Lorangs/TFE4152_prosjektoppgave/README.txt

TFE4152 Design av Integrete kretser, prosjektoppgave H24

Dato:           14. oktober 2024
Skrevet av:     Lorang Strand & Sebastian W. Kalland.

Icarus Verilog er brukt som komilator for Verilog. 
kilde: https://steveicarus.github.io/iverilog/

Youtube video for introduksjon til Verilog:
https://www.youtube.com/watch?v=nblGw37Fv8A&t=5138s

Terminal kommandoer for simulering av Verilog testbenker:

iverilog FILEPATH
vvp OUTPUTFILE
gtkwave VCDFILE
