Lorangs/TFE4152_prosjektoppgave/LaTeX_2/main.tex

\documentclass{article}
\usepackage{graphicx} % Required for inserting images
\usepackage{svg} % Makes it possible to include svg-images
\usepackage{cite}
\usepackage[a4paper, total={6in, 8in}]{geometry}
\usepackage{float}
\usepackage{siunitx}
\usepackage{minted}
\usepackage{titlesec}

% --- Mathematics ---
\usepackage{bm}         % Bold text in math mode
\usepackage{amsmath}    % Math formulas and improved typographical quality of their output
\usepackage{amssymb}    % Extended symbol collection
\usepackage{amsthm}     % Helps define theorem-like structures
\usepackage{textcomp}   % Used in the package "gensymb" (below), which will give warnings if "textcomp" is not imported in advance
\usepackage{gensymb}    % Adds extra generic symbols for math and text mode, e.g. \degree
\usepackage{subfigure}
\usepackage{subcaption}

% --- Main matter ---
% This is the main part of the paper.
\newcommand{\mainmatter}{
    \newpage
    \pagenumbering{arabic}  % Setting page numbering to normal integers
}

\usepackage[colorlinks=true,allcolors=black]{hyperref}
\usepackage[british]{babel}     % Defining UK English as language. This will among other things ensure that dates are displayed as 24/03/1997 rather than 03/24/1997 in the bibliography.
\addto\extrasbritish{   % Change naming of different functions, e.g. figure references.
    \renewcommand*\contentsname{Table of Contents}  % Rename table of contents
    \renewcommand{\listfigurename}{List of Figures} % Rename list of figures
    \renewcommand{\listtablename}{List of Tables}   % Rename list of tables
    \def\equationautorefname{Equation}              % Autoref-name for equations
    \def\figureautorefname{Figure}                  % Autoref-name for figures
    \def\tableautorefname{Table}                    % Autoref-name for tables
    \def\sectionautorefname{Section}                % Autoref-name for sections
    \def\subsectionautorefname{Subsection} % Autoref-name for subsections
    \def\subsubsectionautorefname{Subsection} % Autoref-name for subsubsections
}

\begin{document}

\begin{titlepage}
\vbox{ }
\vbox{ }
\begin{center}
% Upper part of the page
\includesvg[width=\textwidth]{Figures/logo.svg}\\[1cm]
\textsc{\LARGE TFE4152 Design of Integrated Circuits}\\[1cm]
\textsc{\Large Term project fall 2024}\\[0.5cm]
\vbox{ }

% Title
{ \huge \bfseries 8x8-bit Memory Module}\\[0.4cm] 

% Author
\large
\emph{Authors:}\\
L. Strand \& S.W. Kalland \\
Group 3
\vfill

\end{center}
\end{titlepage}

\input{Text/0_Abstract} \newpage
\tableofcontents \newpage
\input{Text/1_Introduction} 
\input{Text/2_Theory} 
\input{Text/3_Method} \newpage
\input{Text/4_Results} 
\input{Text/5_Discussion} 
\input{Text/6_Conclusion} \newpage

\addcontentsline{toc}{section}{References}
\bibliographystyle{unsrt}
\bibliography{bibliography}

\include{Text/7_appendix.tex}
\end{document}
