Lorangs/TFE4152_prosjektoppgave/aimSpice/plots/plotsFF/func27c.png

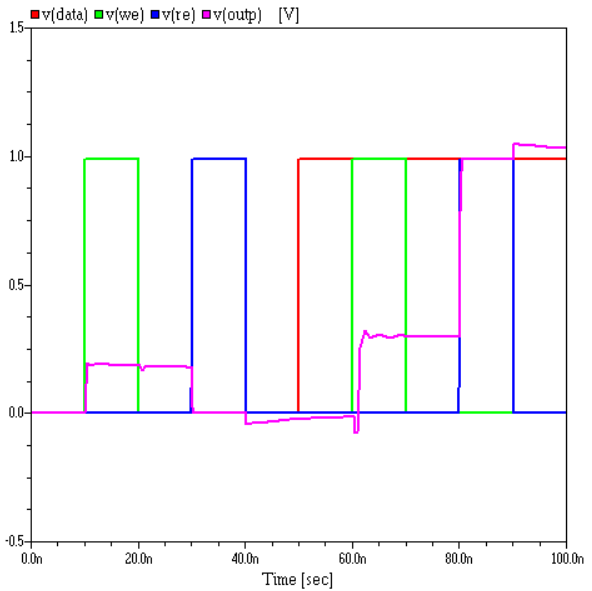
aimSpice/plots/plotsFF/func27c.png
