Lorangs/TFE4152_prosjektoppgave/aimSpice/plots/plotsFF/func50c.png

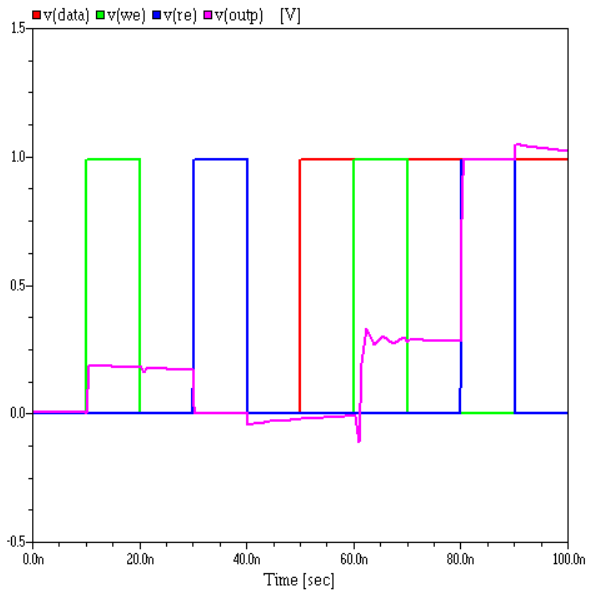
aimSpice/plots/plotsFF/func50c.png
