Lorangs/TFE4152_prosjektoppgave/aimSpice/plots/plotsFF/func-20c.png

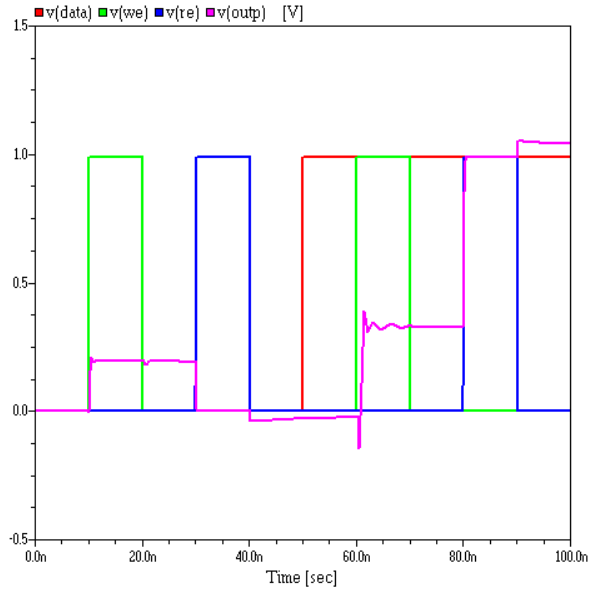
aimSpice/plots/plotsFF/func-20c.png
