Lorangs/TFE4152_prosjektoppgave/aimSpice/plots/plotsFF/leak.png

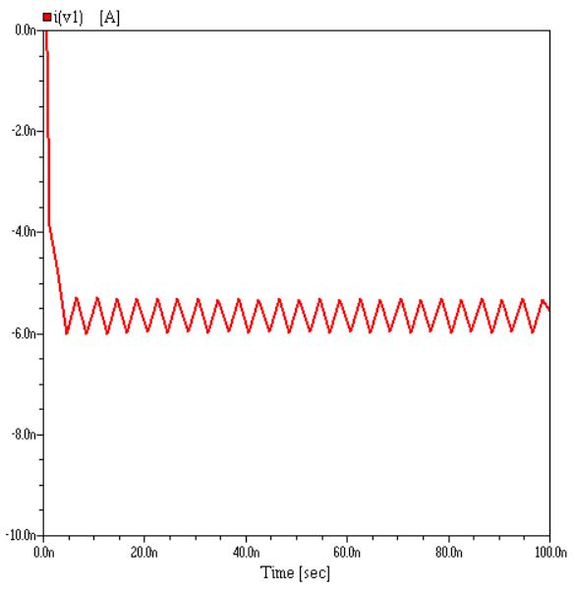
aimSpice/plots/plotsFF/leak.png
