Lorangs/TFE4152_prosjektoppgave/aimSpice/plots/plotsFF/read.png

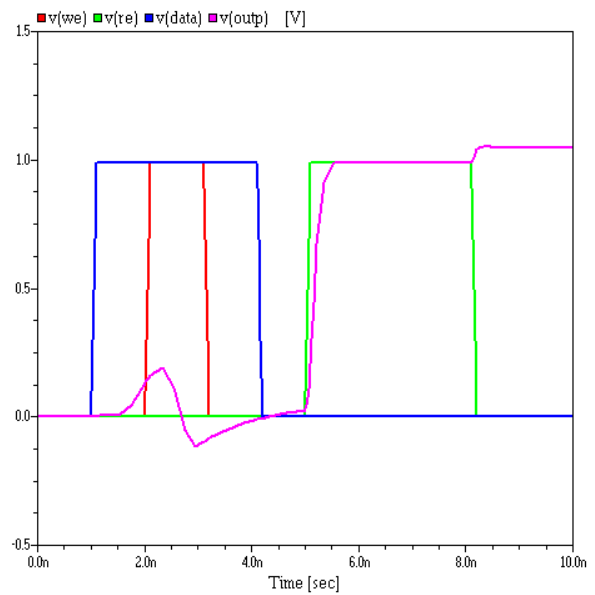
aimSpice/plots/plotsFF/read.png
