Lorangs/TFE4152_prosjektoppgave/aimSpice/plots/plotsFF/write.png

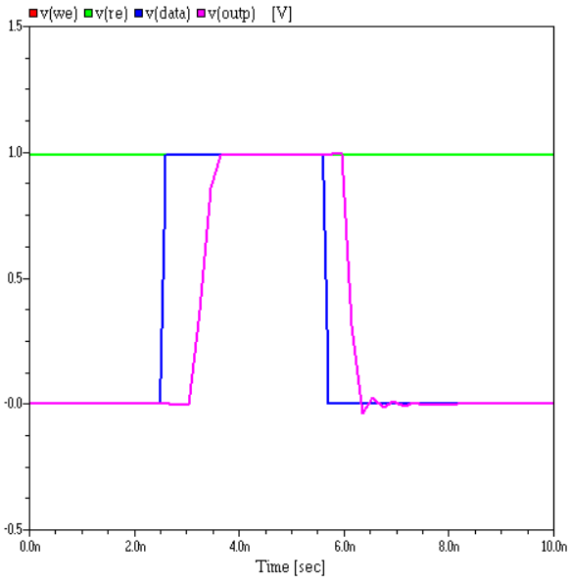
aimSpice/plots/plotsFF/write.png
