Lorangs/TFE4152_prosjektoppgave/aimSpice/plots/plotsFS/func50c.png

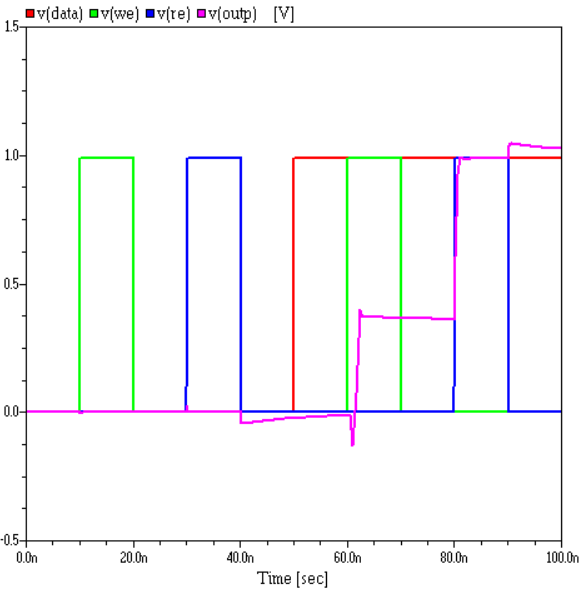
aimSpice/plots/plotsFS/func50c.png
