Lorangs/TFE4152_prosjektoppgave/aimSpice/plots/plotsSF/func27c.png

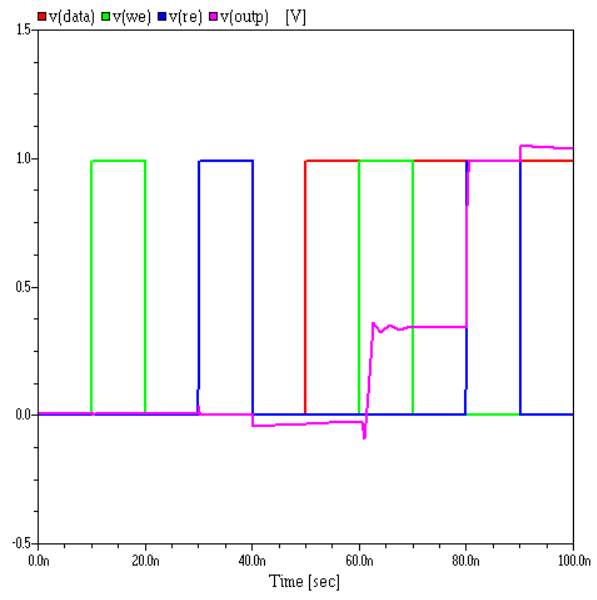
aimSpice/plots/plotsSF/func27c.png
