Lorangs/TFE4152_prosjektoppgave/aimSpice/plots/plotsSS/func50c.png

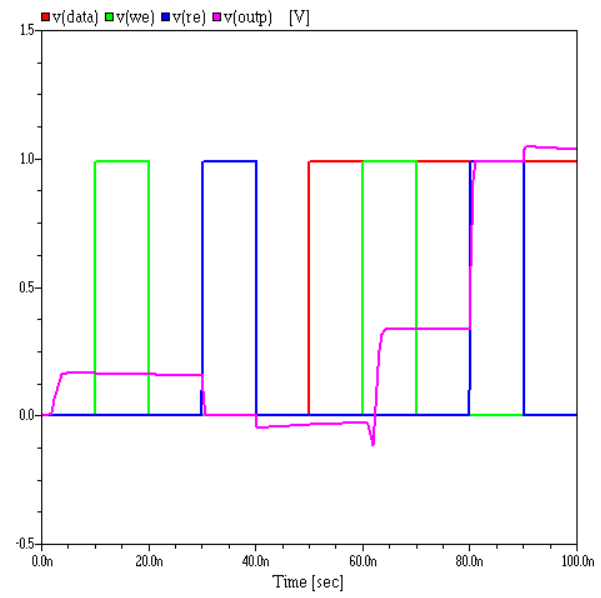
aimSpice/plots/plotsSS/func50c.png
