Lorangs/TFE4152_prosjektoppgave/aimSpice/plots/plotsSS/func-20c.png

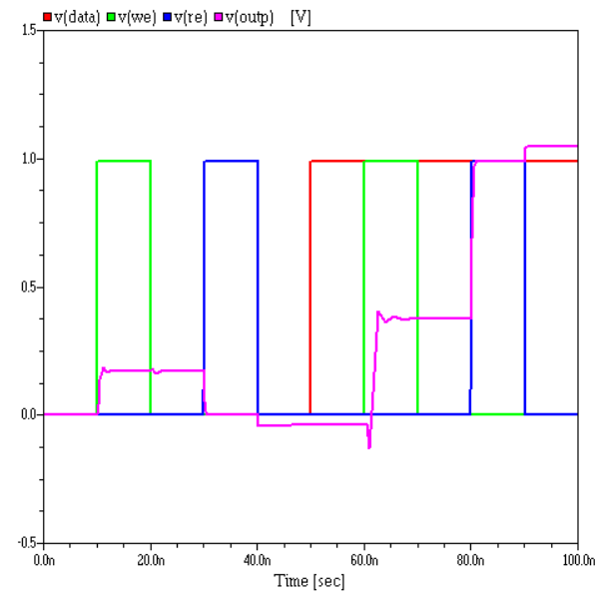
aimSpice/plots/plotsSS/func-20c.png
