Lorangs/TFE4152_prosjektoppgave/aimSpice/plots/plotsSS/read.png

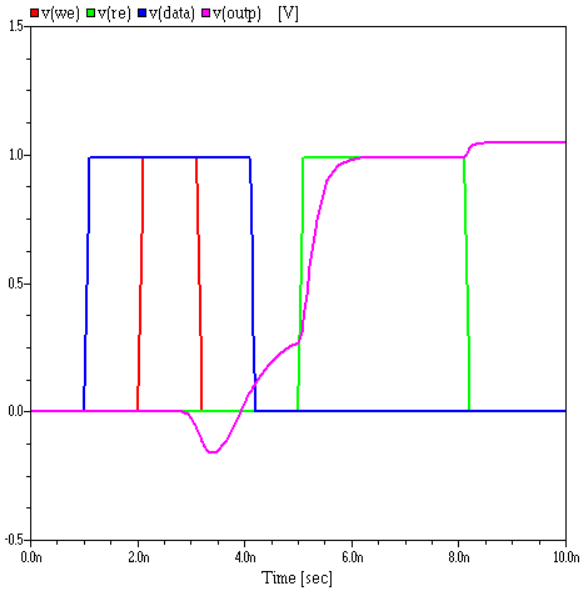
aimSpice/plots/plotsSS/read.png
