Lorangs/TFE4152_prosjektoppgave/aimSpice/plots/plotsTT/read.png

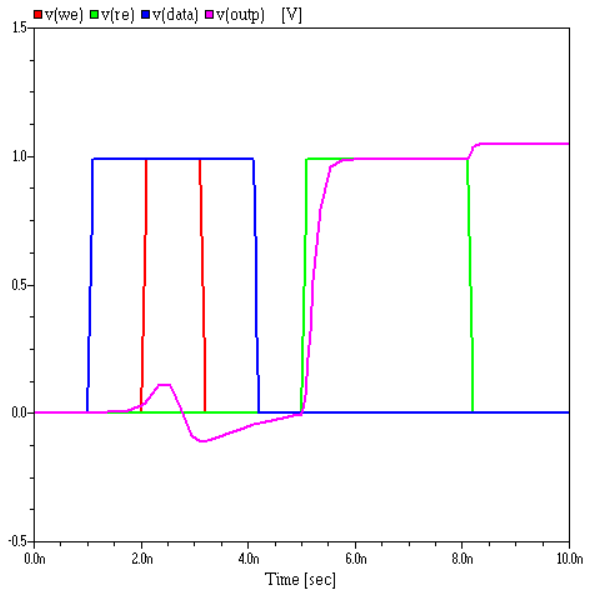
aimSpice/plots/plotsTT/read.png
