Lorangs/TFE4152_prosjektoppgave/aimSpice/plots/plotsTT/write.png

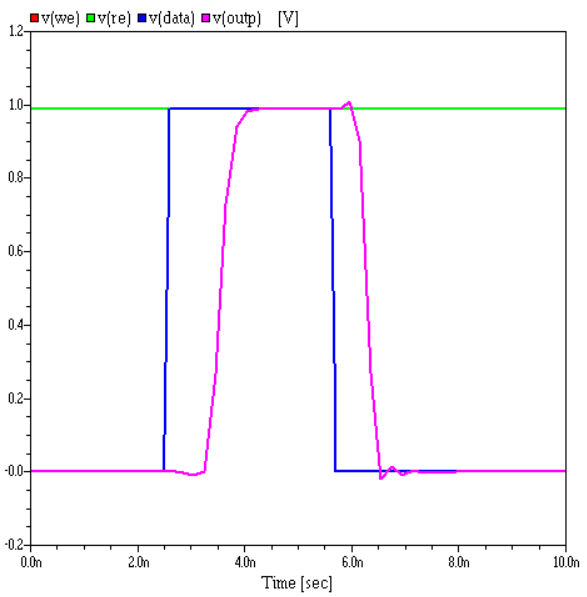
aimSpice/plots/plotsTT/write.png
