Lorangs/TFE4152_prosjektoppgave/LaTeX_2/Figures/flipflop.png

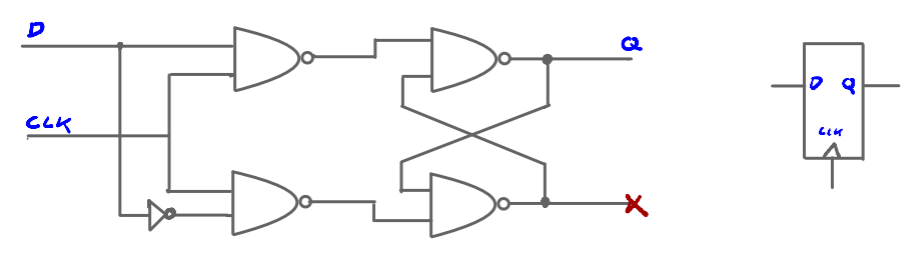
LaTeX_2/Figures/flipflop.png
