Lorangs/TFE4152_prosjektoppgave/LaTeX_2/Text/4_Results.tex

\section{Simulations and Results}   \label{sec:04:results}
All analog simulations are performed in the language of \textit{AIMSpice} in the \textit{AIM-Spice} computer program. All digital simulations are performed in the language \textit{Verilog}, with the editor \textit{VSCode}, compiler \textit{Icarus Verilog} and waveform plotter \textit{gtkwave}. All codes used to simulate can be found in the appendix, \autoref{sec:07:appendix}.

\subsection{Analog bitcell}
The analog behavior of the bitcell is simulated to show its functionality at different temperatures, and its read-time, write-time and leakage current at the \textit{SS}, \textit{TT} and \textit{FF} transistors operating corners.

\subsubsection{Leakage current}
The leakage currents at different configurations are shown in \autoref{fig:04:leakage}. The current is negative, so keep in mind that it is the absolute value of the current which is of interest. It would ideally be as close to zero as possible to keep power consumption down.

\begin{figure}[H]
    \centering
    
    
    
    \caption{Leakage currents at \textit{SS}, \textit{TT} and \textit{FF} (from left to right).}
    \label{fig:04:leakage}
\end{figure}

\subsubsection{Read time}
The read times can be seen in \autoref{fig:04:read}. They are all shorter than \SI{3}{ns}, which is the length of the \textit{RE} pulse, as was required in the project description.

\begin{figure}[H]
    \centering
    
    
    
    \caption{The read times to the bitcell at \textit{SS}, \textit{TT} and \textit{FF} (from left to right) can be read as the time it takes v(outp) to reach v(re).}
    \label{fig:04:read}
\end{figure}

\subsubsection{Write time}
The write times can be seen in \autoref{fig:04:read}. They are also all shorter than \SI{3}{ns}, which is the length of the \textit{inp} pulse, as was required in the project description.

\begin{figure}[H]
    \centering
    
    
    
    \caption{The write times to the bitcell at \textit{SS}, \textit{TT} and \textit{FF} (from left to right) can be read as the time it takes \textit{v(outp)} to reach \textit{v(data)}.}
    \label{fig:04:write}
\end{figure}

\subsubsection{Temperature Functionality}
The circuit is tested at three different temperatures (\SI{-20}{C}, \SI{27}{C}, \SI{50}{C}) for five different circuit configurations (\textit{FF, FS, SF, SS, TT}). The test is comprised of writing, storing and reading a logical low, and then a logical high. The functionality tests perform as can be seen in \autoref{fig:04:func}. 

\begin{figure}[H]
    \centering
    FF:
    
    
    
    \newline
    FS:
    
    
    
    \newline
    SF:
    
    
    
    \newline
    SS:
    
    
    
    \newline
    TT:
    
    
    
    \newline
    
    \caption{The functionality tests of the bitcell. The left column is for -20\degree C, the middle column is for +27\degree C, and the right column is for +50\degree C. All tests meet the system requirements.}
    \label{fig:04:func}
\end{figure}

\subsection{Digital bitcell}    \label{sec:04:results:digital_bitcell}
The bitcell's behaviour is digitally simulated being given inputs and showing outputs according to what can be observed in \autoref{fig:04:bitcell_tb}.
\begin{figure}[H]
    \centering
    
    \caption{Testbench of the bitcell}
    \label{fig:04:bitcell_tb}
\end{figure}
In the testbench we read the bitcell before any value has been set, expecting a undefined output, $X$ (gray area). Then we write a logic high, read the logic high, write a logic low, and read that too. When \textit{RE} is low, we expect to see a high-impedance value, $Z$, which is observed as the \textit{outp} line being between logical low and high. \textit{REN} is not shown in the figure, since it is trivial. The subsystem performed exactly as expected.

\subsection{Demux}
The demux' behaviour is digitally simulated being given inputs and showing outputs according to what can be observed in \autoref{fig:04:demux_tb}.

\begin{figure}[H]
    \centering
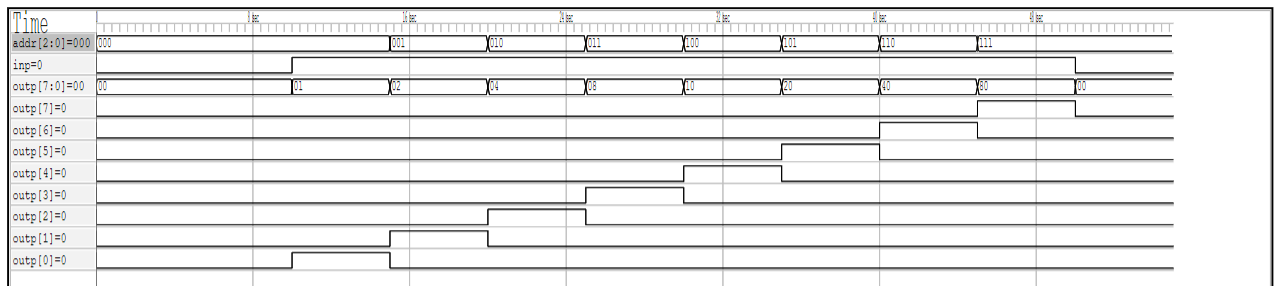
[picture p37: LaTeX_2/Figures/demux1to8_tb.png]
    
    \caption{}
    \label{fig:04:demux_tb}
\end{figure}
In the testbench we cycle through all of the outputs, checking that each of them can be set high, and that all the other ones are low if that is the case. The subsystem performed exactly as expected.

\subsection{RAM}
The RAM subsystem's behaviour is digitally simulated being given inputs and showing outputs according to what can be observed in \autoref{fig:04:ram_tb}.
\begin{figure}[H]
    \centering
    
    \caption{Testbench of the RAM}
    \label{fig:04:ram_tb}
\end{figure}
In the testbench we write the 8-bit hex value \textit{AA} into address $001$, and read that value. Then, we go to address $010$ and read what is stored there, which should be undefined, $XX$, since nothing has been written to this address yet. We then write the hex value $AB$ to this address and read to observe that it has changed from $XX$ to $AB$. The subsystem performed exactly as expected.

\subsection{FSM}
The FSM subsystem's behaviour is digitally simulated being given inputs and showing outputs according to what can be observed in \autoref{fig:04:FSM_tb}.
\begin{figure}[H]
    \centering
    
    \caption{Testbench of the FSM}
    \label{fig:04:FSM_tb}
\end{figure}

In the testbench we check that the FSM can enter all of its four states: 

\begin{itemize}
    \item We start by waiting two clock cycles for it to settle into the \textit{IDLE} state. 
    \item Then we set \textit{sel} high, which causes the FSM to go into the \textit{READ} state on the next rising edge, which can be seen by the FSM's outputs. 
    \item After making sure the state is stable, we set \textit{op} high as well, causing the FSM to go into the \textit{WRITE} state. 
    \item Here it will go to the \textit{STABLE} state on the next clock cycle, no matter the input, but we keep the inputs as before to make sure it then goes back to \textit{WRITE} again. 
    \item Lastly, we observe the FSM going back to \textit{IDLE} when both inputs are low.
\end{itemize}
The FSM performed as expected.

\subsection{Complete memory module} \label{sec:04:results:complete_memory_module}
The behaviour of the complete memory module system, with the FSM subsystem controlling the inputs to the RAM subsystem, is digitally simulated being given inputs and showing outputs according to what can be observed in \autoref{fig:04:mem_system_tb}.
\begin{figure}[H]
    \centering
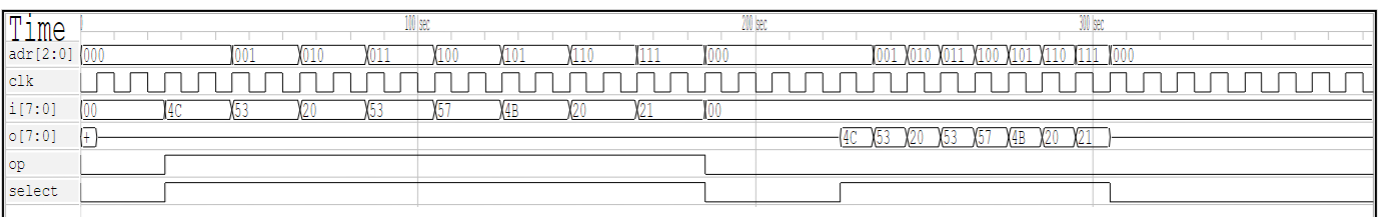
[picture p38: LaTeX_2/Figures/mem_system_tb.png]
    
    \caption{Testbench of the complete memory module}
    \label{fig:04:mem_system_tb}
\end{figure}

In this testbench we write our initials into the memory module, and then read them back. The ASCII string to store is \textit{"LS SWK !"}, which converted to hex is $[4C, 53, 20, 53, 57, 4B, 20, 21]$. Writing takes two clock cycles per word, since the FSM has to go into the \textit{STABLE} state, and reading takes one clock cycle. The completed system performed as expected.
