Lorangs/TFE4152_prosjektoppgave/verilog_mem8x8_m_tri_state_buffer/simple_testbenches/FSM_tb.pdf

Time ⁰ | 100 sec

clk=1
op=0
sel=0
valid=0
rw=1
