Lorangs/TFE4152_prosjektoppgave/verilog_mem8x8_m_tri_state_buffer/simple_testbenches/bitcell_m_invert.pdf

0 | 10 sec | 20 sec | 30 sec | 40 sec | 50 sec Time

inp=0
inpn=1
re=1
ren=0
we=0
outp=0
