Lorangs/TFE4152_prosjektoppgave/verilog_mem8x8_m_tri_state_buffer/simple_testbenches/bitcell_u_invert.pdf

0 | 10 sec | 20 sec | 30 sec | 40 sec | 50 sec Time

inp=0
re=1
we=0
outp=0
