Lorangs/TFE4152_prosjektoppgave/verilog_mem8x8_m_tri_state_buffer/simple_testbenches/bytecell_u_invert.pdf

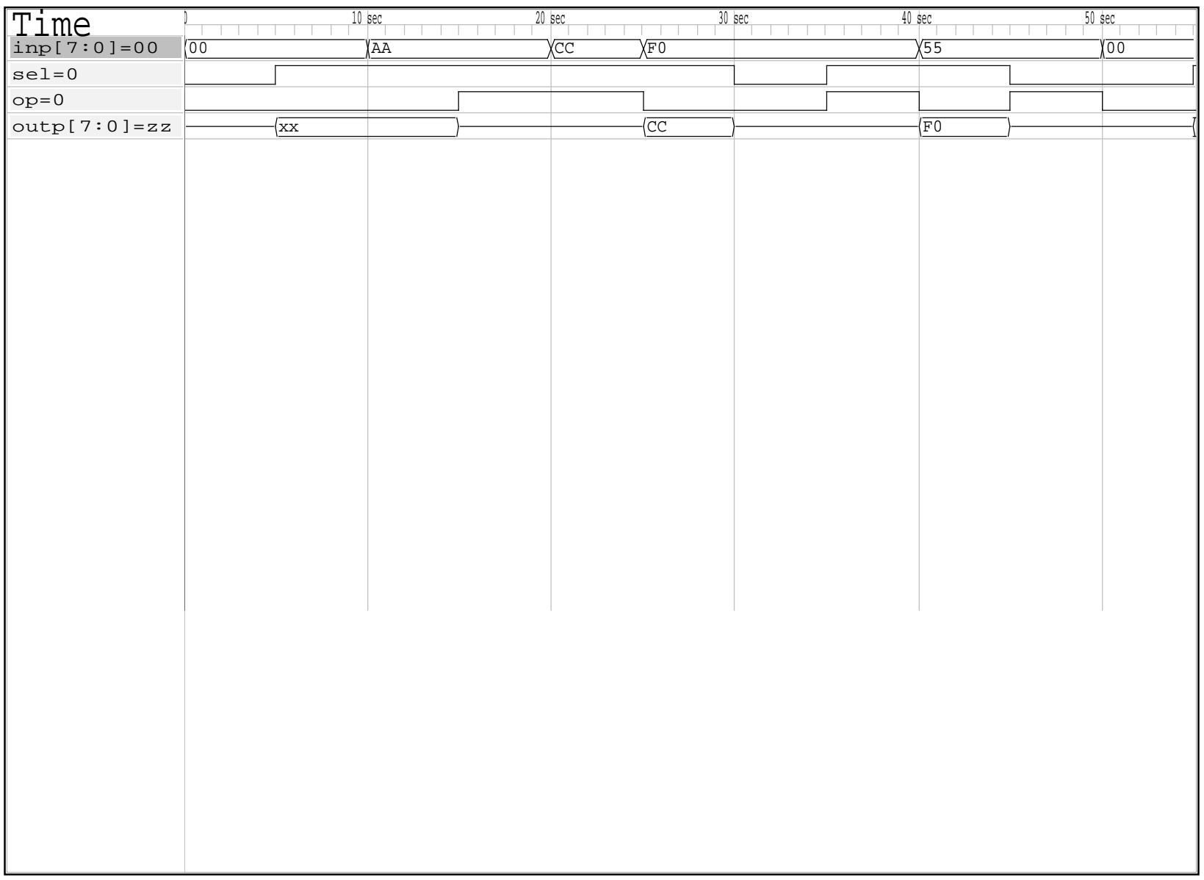
[picture p39: figure]
10 sec; 20 sec; 30 sec; 40 sec; 50 sec; Time; inp[7:0]=00 sel=0 op=0 outp[7:0]=zz
