Lorangs/TFE4152_prosjektoppgave/verilog_mem8x8_m_tri_state_buffer/simple_testbenches/ram.pdf

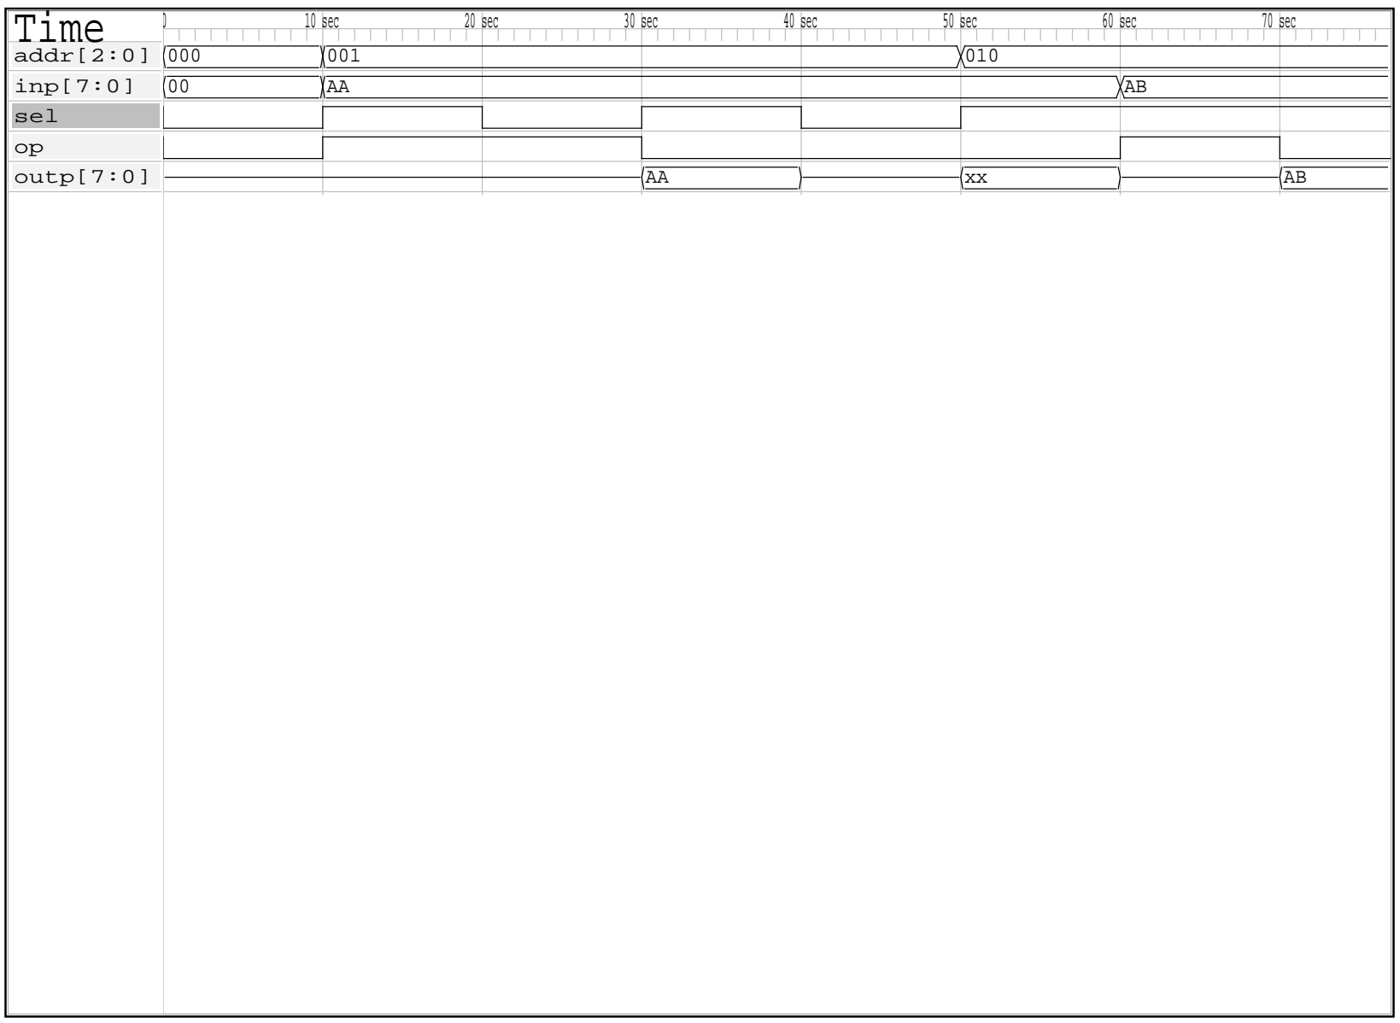
[picture p40: figure]
10 sec; 20 sec; 30 sec; 40 sec; 50 sec; 60 sec; 70 sec; Time; addr[2:0] inp[7:0] sel op outp[7:0]
