Lorangs/TFE4152_prosjektoppgave/verilog_mem8x8_latch/simple_testbenches/bitcell.pdf

Time⁰ | 10 sec | 20 sec | 30 sec | 40 sec | 50 sec

inp=0
outp=1
re=1
ren=0
we=0
wen=1
