Lorangs/TFE4152_prosjektoppgave/verilog_mem8x8_m_tri_state_buffer/simple_testbenches/bytecell.pdf

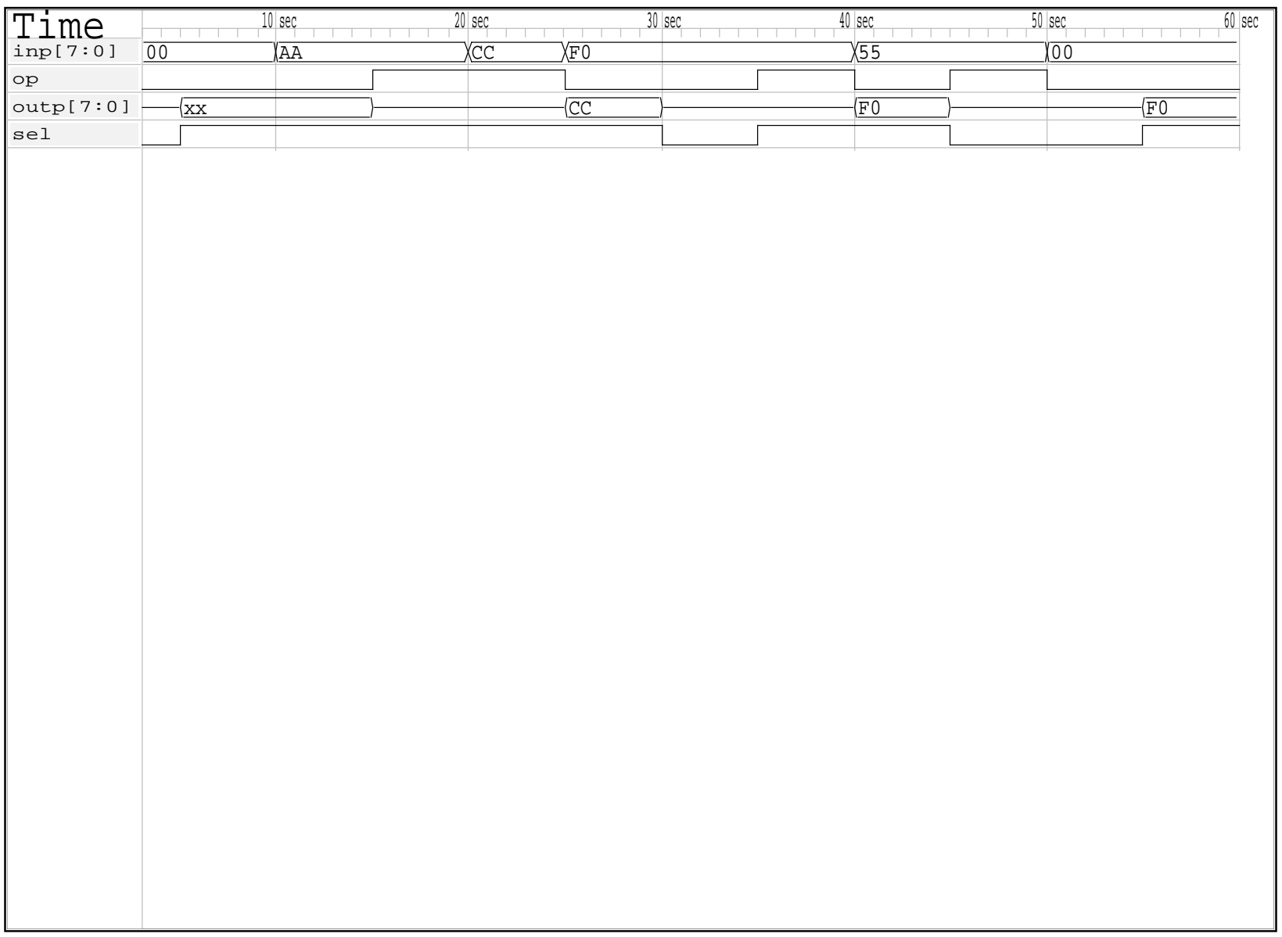
[picture p41: figure]
10 sec; 20 sec; 30 sec; 40 sec; 50 sec; 60 sec; Time; inp[7:0] op outp[7:0] sel
