Lorangs/TFE4152_prosjektoppgave/verilog_mem8x8_m_tri_state_buffer/simple_testbenches/demux1to8.pdf

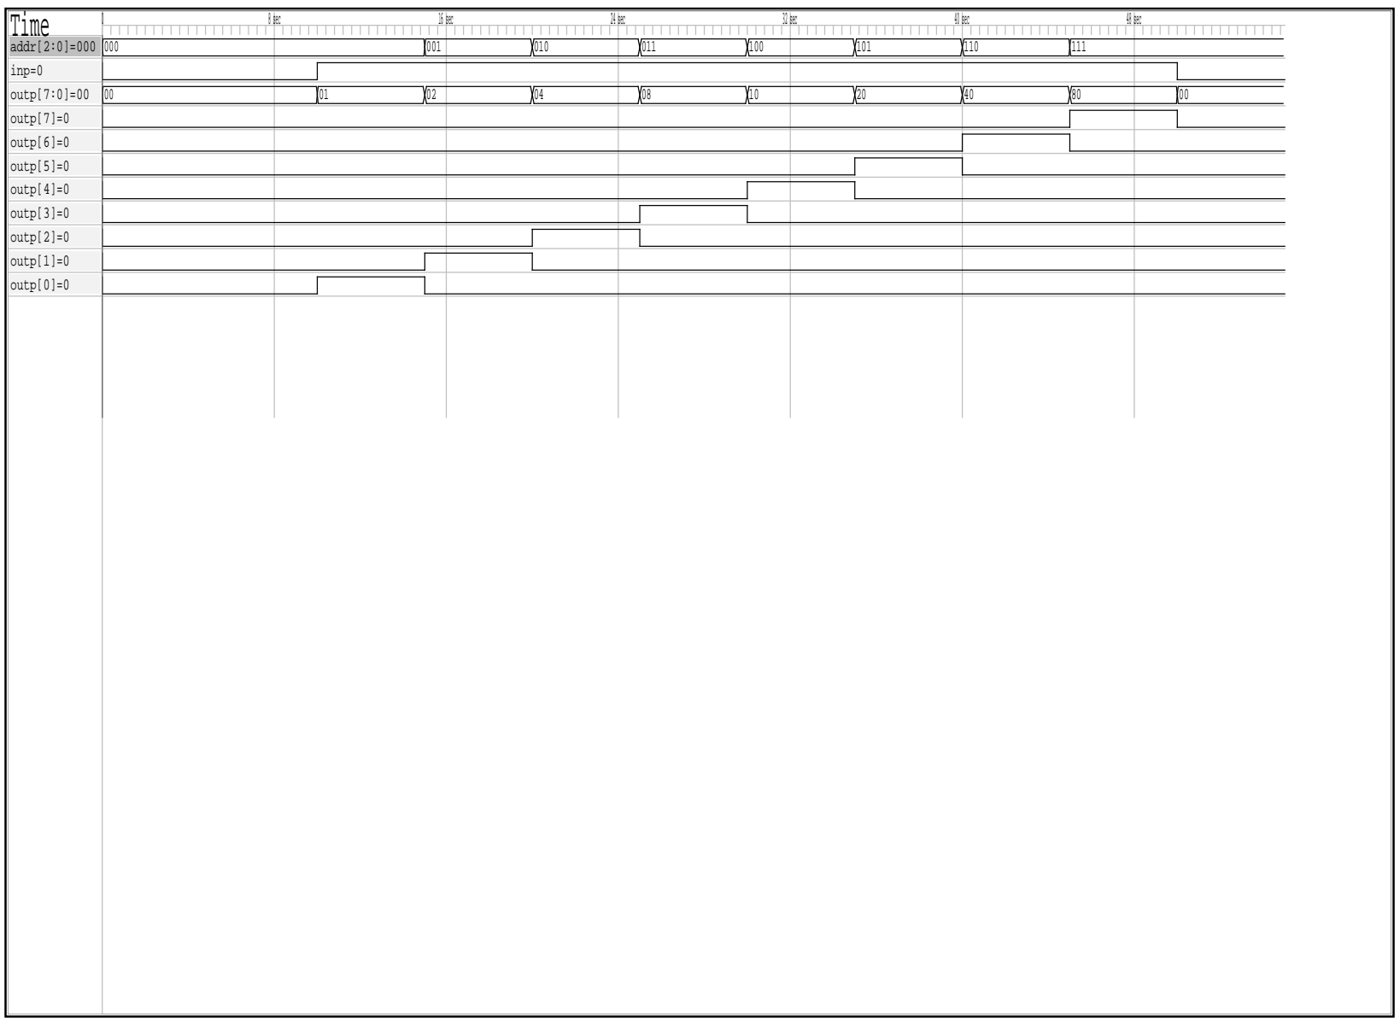
[picture p42: figure]
8 sec; 16 sec; 24 sec; 32 sec; 40 sec; 48 sec; Time; addr[2:0]=000 inp=0 outp[7:0]=00 outp[7]=0 outp[6]=0 outp[5]=0 outp[4]=0 outp[3]=0 outp[2]=0 outp[1]=0 outp[0]=0
