Lorangs/TFE4152_prosjektoppgave/verilog_mem8x8_m_tri_state_buffer/simple_testbenches/mem_system.pdf

# Time

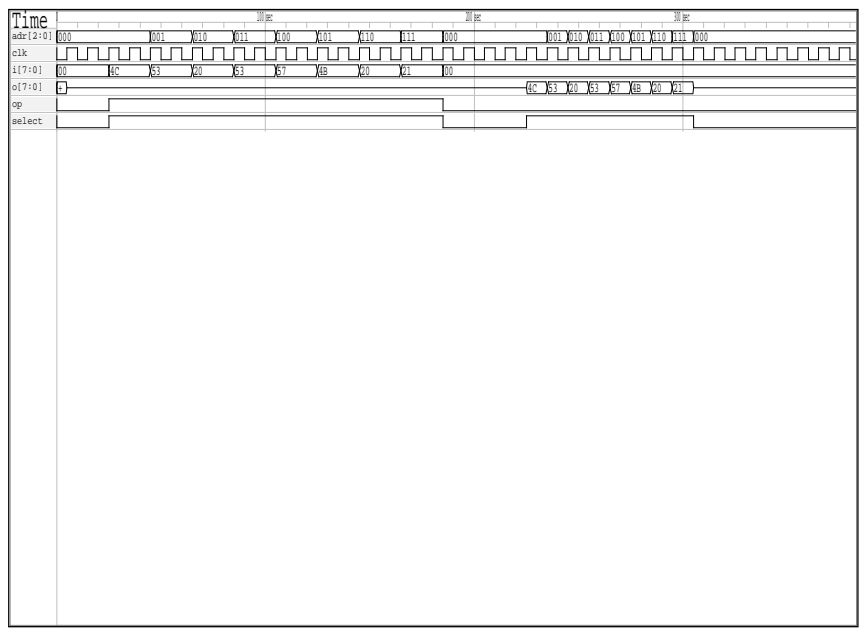
[picture p43: page 1]
100 sec; 200 sec; 300 sec; adr[2:0]; clk; select
