Lorangs/TFE4152_prosjektoppgave/verilog_mem8x8_m_tri_state_buffer/simple_testbenches/bytecell_m_invert.pdf

# Time

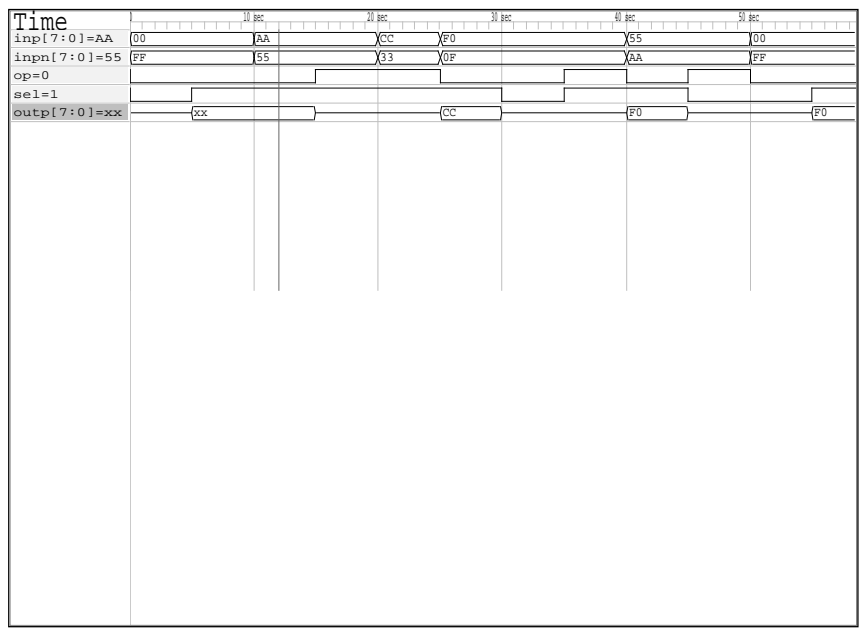
[picture p44: page 1]
10 sec; 20 sec; 30 sec; 40 sec; 50 sec; inp[7:0]=AA inpn[7:0]=55 op=0 sel=1 outp[7:0]=xx
