Lorangs/TFE4152_prosjektoppgave/verilog_mem8x8_m_tri_state_buffer/simple_testbenches/ram_tb_v2.pdf

# Time

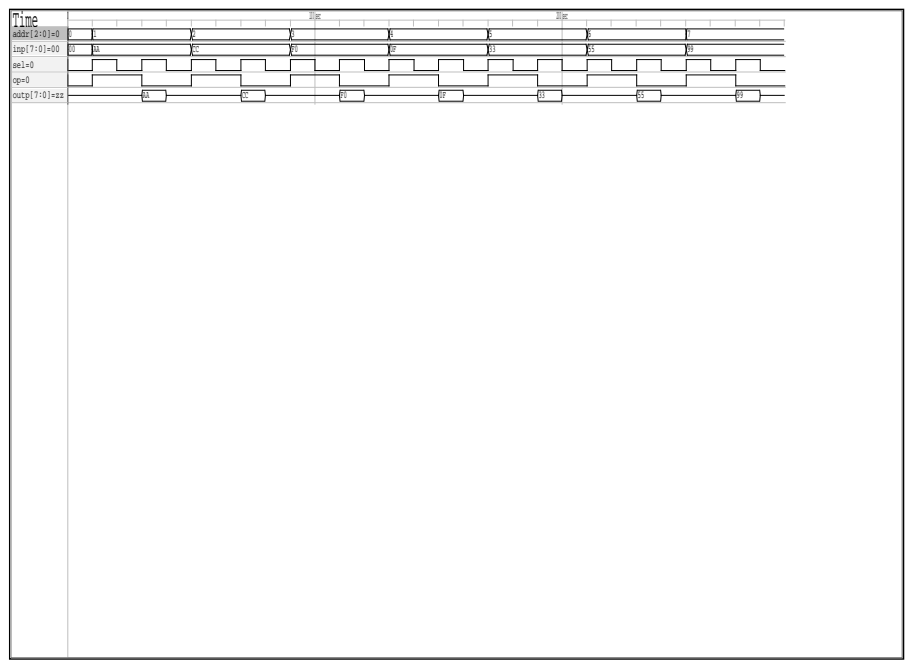
[picture p45: page 1]
100 sec; 200 sec; addr[2:0]=0 inp[7:0]=00 sel=0 op=0 outp[7:0]=zz
