Lorangs/TFE4152_prosjektoppgave/(commit log)

2024-10-14 our indian saviour has bestowed upon us some "kompetanse"~~~~♥♥
2024-11-11 cleaned up some unwanted files
    [library.cfg]
2024-11-18 extra voltage plots
